HamedAbbas1420/Mobile-Robot-Manipulator/Robot CARM mechanical design/CARM.png

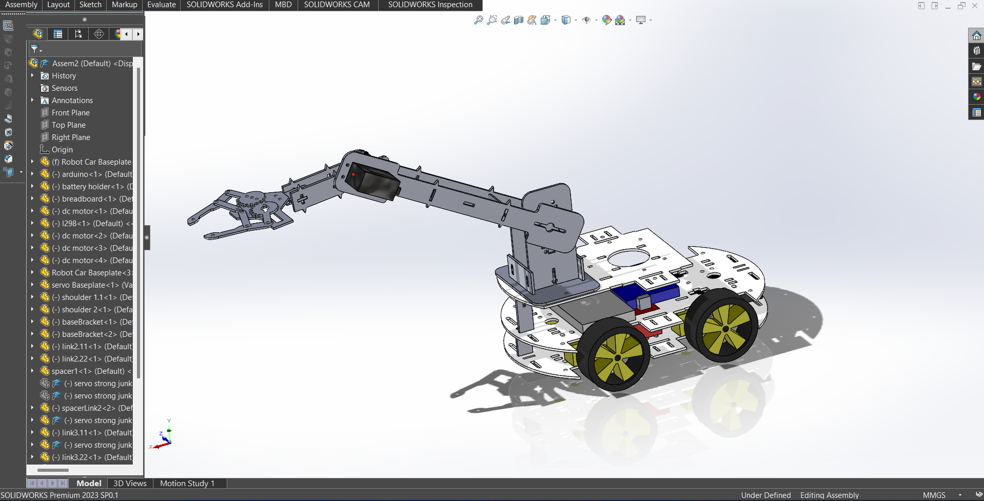
Robot CARM mechanical design/CARM.png
