HamedAbbas1420/Mobile-Robot-Manipulator/Robot Electronics/Robot  CARM electronics.png

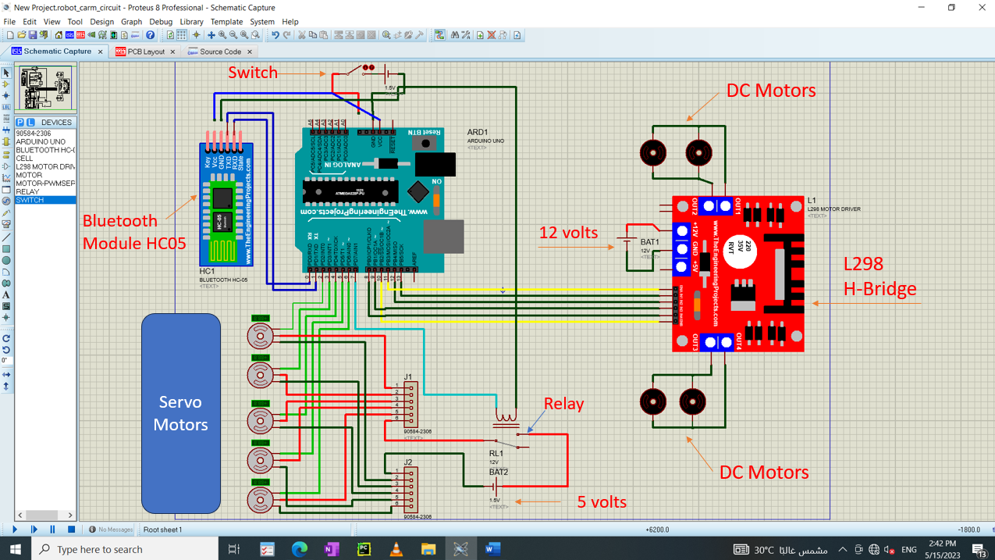
Robot Electronics/Robot CARM electronics.png
